pStrikeZ/RhythKeyPro/doc/readme_en.md

# RhythKey Pro User Manual

## 3D Printing the Controller Case

Please go to [Releases](https://github.com/pStrikeZ/RhythKeyPro/releases) to download the `.3mf` model files for the case,  
or use your favorite 3D modeling software to open and modify the `.step` files in the `/case` directory.  
You can contact a friend with a 3D printer or use a paid 3D printing service on the internet to print them.

The 3mf file with the `with Text` suffix is a version with logos and memes. If your chosen 3D printing service provider supports multi-color material mixing printing, it is recommended to use this model file and fully inform the provider of the color configuration used when submitting the printing request.



## PCB Printing

You can use [JLCPCB EDA Pro](https://pro.lceda.cn/) to log in and import the `.epro2` format files located in the `/pcb` directory, export the Gerber files, and then go to JLCPCB's online PCB ordering service to print the PCB.

Alternatively, if you do not need to review or modify the PCB, you can go directly to [Releases](https://github.com/pStrikeZ/RhythKeyPro/releases) to download the Gerber files.

It is recommended to choose a white PCB to make the silkscreen on the front of the circuit board look more beautiful.

Note: Since I used some footprints without electrical information when drawing the PCB, the electrical schematic function in the EDA has no reference value.

## BOM Component Sourcing

First, you need to purchase the electronic components for the BOM. The list of these components is as follows, roughly divided into two categories: `Mandatory Accessories` and `Optional Accessories`. However, it is recommended to purchase and assemble all accessories.

### Mandatory Accessories

* 1x [Sparkfun Arduino Pro Micro 5V/16MHz](https://www.sparkfun.com/pro-micro-5v-16mhz.html)  
It can also be a compatible version produced by other manufacturers, as long as it is a module equipped with the ATMega32U4 main control chip running at 5V and 16MHz.  
Do not buy the version using the Mini-USB interface, as its PCB size does not match our PCB, ~~and I believe you should find it hard to find such a data cable in 2026~~.  
Do not buy the 3.3V / 8MHz version, as its operating voltage is incompatible with other components on the PCB, and its clock frequency is only half that of the 5V version, which will affect the module's performance.  
It is recommended to buy a version with pre-soldered pins for convenient and quick use.
* 12x Your favorite 5-pin mechanical keyboard switches  
When I was improving the design of this rhythm game controller, a friend asked me if I could use optical switches or electrostatic capacitive switches to improve the absolute gaming experience in rhythm game scenarios.  
Regrettably, the answer is no. The actuation force / travel distance adjustment functions of optical or electrostatic capacitive switches cannot be implemented using an Arduino-based main control scheme by a student without the help of any professional tuning equipment.
* 12x Kailh mechanical keyboard switch sockets
* 8x 1U size mechanical keyboard keycaps and 4x 2.75U size mechanical keyboard keycaps
* 4x 2U size mechanical keyboard stabilizers  
Most of the time, you will be bundled by the seller with a 6.5U or 7U length stabilizer suitable for the space bar of a mechanical keyboard, which is normal.
* 2x EC11 rotary encoders and 2 matching knob caps  
  > **⚠️ Note:** The SOUND VOLTEX knob section of this project uses **rotary encoders**, which output digital pulse signals. Do not confuse them with traditional potentiometers that output analog signals.
  
  There are two main assembly options for encoder selection. Considering gameplay feel and assembly cost, **this project strongly recommends Option A (third-party encoder with detent removal modification)**.
  
  **Option A: Third-party EC11 encoder + physical modification (author recommended)**  
  Since ALPS imported encoders are very expensive (approximately 7.5x the cost of domestic encoders), using common third-party/domestic EC11 encoders is an excellent alternative.
  * **Purchasing:** Simply select any commonly available low-cost EC11 encoder (they typically come with physical detents).
  * **Modification:** Encoders with detents produce noticeable resistance bumps during rotation, which greatly affects the SDVX gameplay experience. It is recommended to perform a physical modification before soldering: **Use a tool to open the metal casing of the encoder, and completely flatten the spring metal tab that contacts the gear wheel inside, to eliminate the physical detent feel.**
  
  * **Experience:** After modification, the encoder will be in an ultra-low friction state due to the lack of high-viscosity damping grease inside. This lightweight and inertia-carrying smooth feel actually closely resembles the gameplay experience of arcade original photoelectric encoders. The downside is that mechanical contact lifespan is relatively limited — if signal jitter occurs after several months of intensive use, simply replace the encoder.
  
  **Option B: ALPS original EC11 encoder (detent-free version)**  
  If you prefer not to perform any physical modification, you can purchase the original ALPS imported EC11 encoders from Japan.
  * **Purchasing:** ALPS offers two versions: `EC11E09244BS` with detents and `EC11E1834403` with smooth detent-free rotation. **Be sure to choose the smooth detent-free version (`EC11E1834403`).**
  * **Experience:** The ALPS original detent-free encoder has high-quality damping grease inside to improve rotational precision. This results in significantly higher rotational resistance compared to standard encoders. In SDVX scenarios that require fast, high-frequency knob spinning, this produces a noticeable sticky and fatiguing feel. Therefore, from a practical gameplay perspective, it is not the primary recommendation.
  
  **Knob cap purchasing tip:** The metal shaft of EC11 encoders typically comes in two types: **half-round shaft (D-type)** and **splined shaft (knurled/gear-type)**. When purchasing matching metal knob caps, make sure to confirm that the internal bore shape of the knob cap exactly matches the shaft type of your encoder, otherwise it will not fit properly.
* 1x ALPS B10K 60/75mm dual-gang slide potentiometer and 1 slide potentiometer fader cap  
I have purchased both domestic and ALPS imported dual-gang potentiometers. The domestic option's feel and performance are not inferior to the imported parts at all, so the domestic option is recommended — it can also save you 7.5x the money.  
However, note that domestic single-gang slide potentiometers not only have different specifications from dual-gang potentiometers, but also have far worse quality control. Please pay attention to model numbers when purchasing, and if the seller ships the wrong product, apply for after-sales service promptly.
  > It is recommended to purchase potentiometer and encoder knob caps from the same shop where you buy the potentiometers and encoders, which usually saves on shipping costs.
* 7x 6mm*6mm SMD tactile push button switches, button height 7.5mm
* 4x R0805 10KΩ SMD resistors
* 16x R0805 100nF SMD capacitors
* 1x R0805 330Ω SMD resistor
* 12x R0805 1Ω SMD resistors
* 12x WS2812 3528 package reverse-mount RGB LED beads  
Note the search keyword: `SK6812MINI-E` is the correctly packaged reverse-mount version.  
WS2812 is originally a WorldSemi product, but its native package is the front-mount 5050 size. In the custom keyboard community, the most commonly used reverse-mount RGB LED is the SK6812MINI-E.
* 18x R1206 1N4148 switching diodes
* 6x M2*8 self-tapping screws
* 5x M2*16 self-tapping screws
* Soldering iron with adjustable temperature, solder wire, soldering flux, rosin, **and a pair of curved tweezers**  
*Or if you have a hot air gun, maybe try reflow soldering?*

### Optional Accessories

* 2x 2.54mm single-row female headers  
If you do not consider the hot-swappable feature of the module, you can solder the module directly to the motherboard.
* 6x 6mm thick rubber feet  
When using header sockets to connect the Arduino module, the height of the module will exceed the thickness of the 3D printed parts, so several feet are needed to raise it. Raising the knob side by 12mm and the user side by 6mm is sufficient.
* 12x Mechanical switch pads  
Mainly because I really don't think a few pieces of foam can change the sound of the keys of a rhythm game controller with a 3D printed shell to any extent, so it's better not to stick anything. But since you can choose to stick them, I'll mention it here.

## Soldering

Except for the 6 SMD tactile switches located on the front of the motherboard, all SMD electronic components are designed on the back of the motherboard. The silkscreen directly indicates the component model, just put them in the right place.  
After completing the soldering of the SMD components on the back, solder the potentiometers, front SMD switches, female headers, and other parts.  
The completed circuit board should look like the picture below, **although the PCB in the picture is a former Prototype version and is inconsistent with the PCB in the repository**:





## Assembly

* Embed the stabilizers into the top case
* Place the PCB in the bottom case and screw in the M2*8 self-tapping screws
* Place the top case on the bottom case and screw in the M2*16 self-tapping screws
* Install mechanical switches, knob caps, potentiometer caps, and keycaps  
If you feel that the potentiometer cap is very loose on the potentiometer, you can stuff a small piece of paper inside the potentiometer cap, which will increase the friction between the cap and the potentiometer.

The assembled product is shown in the figure:



## Firmware Flashing

### First Time Flashing

First, download and install [Arduino IDE](https://www.arduino.cc/en/software), open the Preferences tab.

Enter `https://raw.githubusercontent.com/dmadison/ArduinoXInput_Boards/master/package_dmadison_xinput_index.json` in Additional Boards Manager URLs, as shown in the figure. If there is already other content in this line, append it to the end, separated by a semicolon.



Then open Boards Manager, search for and install XInput SparkFun Boards.



Next, open Library Manager, search for and install the XInput library and FastLED library.





Then, connect the USB-C interface of the assembled RhythKey Pro to the computer.  
When flashing the firmware for the first time, the exposed COM port can be recognized without the RESET button. Click the pen icon next to the recognized serial port, search for and select `SparkFun Pro Micro w/ XInput`, select the corresponding port on the right, and then select OK.





Next (very important!), click the Tools tab. There is a `Processor: ATMega32U4` option. Click it and be sure to select the `ATMega32U4 (5V, 16 MHz)` item in the pop-up menu, otherwise the module will not be recognized after flashing the firmware.



Then open the `rhythkeyoro_fw.ino` file in the repository, click the `Upload` button in the upper left corner, and wait for the firmware burning to complete.

### Firmware Updating

Since the Pro Micro module will become an XInput device after flashing the XInput firmware, the Arduino IDE will not be able to recognize it. At this time, you need to press the RESET button of the Pro Micro module to make it re-enter Bootloader mode before firmware updating.

This Bootloader mode will only last for 8 seconds, so it will test the user's proficiency in computer operations.

First open the Arduino IDE, press the RESET key once to make the module enter Bootloader mode.  
You need to complete the binding settings of the module port and board type within these 8 seconds (click the pen icon, select the port, select the board type).  
Then, with the module NOT in Bootloader mode, click the Upload button to burn the firmware.  
After the Arduino IDE completes firmware compilation (as shown in the figure below) and displays Uploading, immediately press the RESET button to make it re-enter Bootloader mode, so that the new firmware can be successfully flashed.



## Feature Overview

### Key Mapping

The mechanical switch keys on this controller are mapped to XInput buttons as follows:

| Mechanical Switch Key | XInput Button |
|---|---|
| Left/Right Side Keys | Left/Right Bumpers |
| Left/Right Menu Keys | Left/Right Menu Buttons |
| Left 3 Main Keys | D-PAD Left/Up/Right |
| Right 3 Main Keys | X/Y/B |
| Left Ground Key | D-PAD Down |
| Right Ground Key | A |
| Left Knob Press | LS |
| Right Knob Press | RS |

### Auxiliary Function Keys

There is a row of SMD buttons at the bottom of the controller, from left to right:

* RGB LED Brightness Decrease
* RGB LED Brightness Increase  
  (Note: The system features non-volatile power-off memory. After you finish adjusting brightness and the controller idles for approximately 3 seconds, the system will automatically debounce and smoothly save the setting to the internal EEPROM, avoiding frequent writes that wear out the chip, and the brightness will be automatically restored on next power-up)
* LS Key  
  (Note: Hardwired in parallel with the left knob press at the circuit level; cannot be changed via software)
* RESET Key
* Undefined
* Mode Switch

This controller defines two modes: ONGEKI mode and VARIOUS mode. The two modes have different lighting effects and behaviors.

In ONGEKI mode:

* All mechanical switch keys are available, but the two menu keys need to be held for 3 seconds to be triggered
* The slide potentiometer is mapped to the linear triggers — with the center position as the boundary, sliding left activates the left linear trigger, and sliding right activates the right linear trigger
* Changing RGB LED color effects via the vibration motor data channel is available  
  (Note: Thanks to firmware-level directional filtering optimization, the system proactively immunizes against the global vibration reset `(0,0)` signal triggered by system-level events such as Windows focus loss or pressing the Win key, fundamentally eliminating jarring lighting flicker during gameplay)
* Rotary encoders are completely disabled to prevent accidental input during gameplay

In VARIOUS mode:

* Side keys and menu keys are completely disabled to prevent accidental input during gameplay, and their corresponding LEDs will also turn off
* The slide potentiometer is mapped to the X axis of the right stick
* Changing RGB LED color effects via the vibration motor data channel is not available
* The left and right rotary encoders are mapped to the X axis and Y axis of the left stick respectively

When switching between the two modes, all stick and linear trigger values are cleared to prevent anomalies during gameplay. If the slide potentiometer is not at the center position when switching modes, its mapped target will remain at the center position until the reading changes, at which point the potentiometer's position will be reflected in the mapped target value.

## Game Settings

**Disclaimer**: This project does not provide installation files for any games or tutorials on how to use the games themselves.

### ONGEKI

First switch to ONGEKI mode.

Open `segatools.ini`, adjust other settings, and scroll to the end of the configuration file.

```ini
[io4]
enable=1
; Test button virtual-key code. Default is the F1 key.
test=0x70
; Service button virtual-key code. Default is the F2 key.
service=0x71
; Keyboard button to increment coin counter. Default is the F3 key.
coin=0x72

; Set "1" to enable mouse lever emulation, "0" to use XInput
mouse=0
```

Change the `mouse` item to `0`, then save the configuration file.

Then open `start.bat`, and add this line after the line containing `start "AM Daemon"`:

```cmd
start "LED Sync" /min python "ongeki_led_reader.py"
```

And add this line after the line containing `taskkill /f /im amdaemon.exe`:

```cmd
taskkill /f /fi "WINDOWTITLE eq LED Sync" > nul 2>&1
```

Save the `start.bat` file. Finally, copy the [tools/ongeki_led_reader.py](../tools/ongeki_led_reader.py) file to the directory where `start.bat` is located.

If you don't have Python installed, you can download and install it from [python.org](https://www.python.org/).

Start the game, press `F1` to enter test mode, select `レバー設定` (Lever Settings) and enter.





First select `初期設定に戻す` (Reset to Default), then slowly move the potentiometer to the far left, and then to the far right.  
Next select `終了` (Exit), then `保存する` (Save). After completing other necessary settings, exit test mode and start enjoying the game.

### SOUND VOLTEX

First switch to VARIOUS mode.

Run `spicecfg.exe` or press the `F4` button after entering the game to open the spicetools settings interface.



Click the `Bind` buttons one by one as shown in the figure, and then press the corresponding button on the controller to bind.  
After binding the buttons, switch to the `Analogs` tab.



Bind the two knobs to the `X` axis and `Y` axis of the controller stick respectively, and enable `Smooth Axis`.  
(Note: Since the A/B phase output of domestic EC11 encoders may be reversed compared to ALPS original parts, if you find that the knob rotation direction is completely opposite to the in-game direction during testing, simply check the corresponding `Invert Axis` option in this interface to perform a software inversion — no need to recompile the firmware or change hardware wiring.)

Then exit the settings and start enjoying the game.

### DJMAX RESPECT V

Switch to VARIOUS mode, enter the game, go to Settings -> Control -> Input Settings -> Edit.



After setting up the key mapping, start enjoying the game directly.

### osu!

Use a similar method to DJMAX to set up key mapping and then start enjoying the game.

### In Falsus Demo

Switch to VARIOUS mode, and then make sure to import this layout in Steam.

steam://controllerconfig/4355100/3667527437

Then in Steam Settings -> Controller -> Calibration & Advanced Settings, turn off the deadzone for the right stick, and then enter the game.

Note: Depending on the size of different monitors, you may need to fine-tune the vertical position and size of the mapped stick area yourself.
