pStrikeZ/RhythKeyPro/(list of files, cad)

Other CAD files:
case/RhythKeyPro_Case_Top_with_Text.step
case/RhythKeyPro_Case_Top.step
case/RhythKeyPro_Case_Bottom.step
