pStrikeZ/RhythKeyPro/firmware/rhythkeypro_fw/LEDController.h

#ifndef LED_CONTROLLER_H
#define LED_CONTROLLER_H

#include <FastLED.h>
#include "Config.h"

class LEDController {
public:
    LEDController();
    ~LEDController();

    // 初始化LED
    void begin();

    // 更新LED显示（接收当前模式对应的主题色数组）
    void update(const CRGB* theme);

    // 更新LED显示，带动态覆盖层（rumble 解码的颜色覆盖指定位置）
    void updateWithOverlay(const CRGB* theme, const volatile CRGB* overlay,
                           const uint8_t* indices, uint8_t count);

    // 设置LED亮度
    void setBrightness(uint8_t brightness);

    // 获取LED数量
    uint8_t getLEDCount() const { return hardwareConfig.led.count; }

private:
    CRGB* leds;
    CRGB* prevLeds;  // 上一次 show() 的快照，用于脏检测
    bool initialized;

    // 应用LED主题
    void applyTheme(const CRGB* theme);

    // 脏检测后刷新：仅在 LED 数据变化时调用 FastLED.show()
    void showIfDirty();
};

#endif // LED_CONTROLLER_H
