pStrikeZ/RhythKeyPro/firmware/rhythkeypro_fw/ModeManager.h

#ifndef MODE_MANAGER_H
#define MODE_MANAGER_H

#include <Arduino.h>
#include <XInput.h>
#include <FastLED.h>
#include "Config.h"

class BrightnessManager;  // 前向声明

class ModeManager {
public:
    ModeManager();
    ~ModeManager() = default;

    // 设置亮度管理器引用
    void setBrightnessManager(BrightnessManager* mgr) { brightnessManager = mgr; }

    // 处理按钮矩阵的所有事件（含切换键检测 + 亮度调节 + 过滤 + XInput 发送）
    void processButtons(const bool currentState[3][6], const bool prevState[3][6]);

    // 获取当前模式对应的 LED 主题色数组
    const CRGB* getLEDTheme() const;

    // 获取当前模式
    ControllerMode getMode() const { return currentMode; }
    bool isOngekiMode() const { return currentMode == MODE_ONGEKI; }

    // 检测并消费模式变更事件（调用后自动清除标志）
    bool consumeModeChanged() { bool changed = modeChanged; modeChanged = false; return changed; }

private:
    ControllerMode currentMode;
    bool modeChanged;
    BrightnessManager* brightnessManager;  // 由 RhythKeyController 注入

    // 切换键在矩阵中的坐标
    static const uint8_t TOGGLE_ROW = 0;
    static const uint8_t TOGGLE_COL = 5;

    // 长按状态追踪
    struct LongPressState {
        unsigned long pressStartTime; // 按下起始时间
        bool tracking;               // 正在追踪中（物理按下但未达到阈值）
        bool pressSent;              // 已发送按下事件
    };
    LongPressState longPressState[2]; // 与 gameConfig.longPress.count 对应

    // 处理模式切换键
    void handleToggle(bool currentState, bool previousState);

    // 判断按键是否被当前模式屏蔽
    bool isButtonMasked(uint8_t row, uint8_t col) const;

    // 模式切换时释放所有被屏蔽的按键
    void releaseMaskedKeys();

    // 发送单个按键的 XInput 事件
    void sendButtonEvent(bool currentState, bool previousState, uint8_t row, uint8_t col);

    // 长按按键处理
    int8_t getLongPressIndex(uint8_t row, uint8_t col) const;
    void handleLongPressButton(bool currentState, uint8_t row, uint8_t col, uint8_t index);

    // 亮度键处理（返回 true 表示已处理，应跳过后续逻辑）
    bool handleBrightnessKey(bool currentState, bool previousState, uint8_t row, uint8_t col);
};

#endif // MODE_MANAGER_H
