pStrikeZ/RhythKeyPro/(commit log)

2026-02-16 重构事件处理的业务逻辑
2026-02-16 给音击模式的菜单键上防误触 将电位器的逻辑也独立成模块封装 在其他音游模式下将电位器的映射从线性扳机改为右摇杆Y轴
2026-02-16 在切换控制模式时重置旋钮映射的状态
2026-02-16 修改右旋钮和电位器的映射
2026-02-16 更新文档
2026-02-17 完善固件烧录部分的文档
2026-02-17 反转右编码器的方向
2026-02-18 更新模型文件，PCB工程文件和许可证
    [PCB_subtitute.SLDPRT, RhythKeyPro_Case_Bottom.step, RhythKeyPro_Case_Top.step, RhythKey_Pro_A0.epro, board_bottom.SLDPRT, board_bottom.STL, board_up.SLDPRT, board_up.STL]
2026-02-18 替换pcb上滑动电位器的封装
2026-02-18 添加英文文档
2026-02-23 添加带文字版本的上盖模型
    [RhythKeyPro_Case_Top_with_Text.step]
2026-02-23 添加图片引用
2026-02-24 更换meme模型，之前那个对打印机要求太高了
    [RhythKeyPro_Case_Top_with_Text.step]
2026-02-24 实现将音击的灯效推送到手台的功能
2026-02-24 修复灯效wrapper被添加到segatools中随游戏启动时窗口失焦导致手台灯效恢复默认的问题
2026-02-25 为什么不用ESP32？
2026-02-25 更新英文文档
2026-02-25 再次更新正面盖板模型更换logo
    [RhythKeyPro_Case_Top_with_Text.step]
2026-02-26 更新文档中有关编码器选购的表述
2026-02-26 更新上盖模型：优化对国产EC11编码器的兼容性
    [RhythKeyPro_Case_Top_with_Text.step]
2026-02-28 令旋转编码器仅在VARIOUS模式下工作，防止玩音击时误触
2026-02-28 切换模式时确保将清零后的旋钮状态发送回主机
2026-03-05 新功能：带保存的RGB灯亮度调节
2026-03-06 上传A1版本的EDA工程文件
